bsakel/dsky-ha-terminal/software/README.md

# Pi Zero 2 W software (to do)

The Pi Zero 2 W runs the HyperPixel 4.0 Touch with the Pimoroni driver overlay. It shows a DSKY-style Home Assistant UI, for example a kiosk browser or a small native app, talks to the RP2040 over USB serial, and maps VERB/NOUN key sequences to Home Assistant services.
