bsakel/dsky-ha-terminal/docs/img/ha_front.png

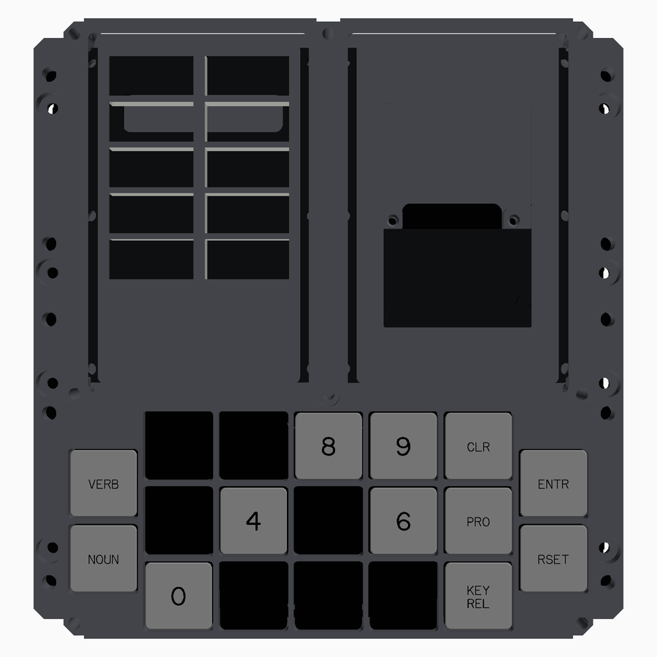
docs/img/ha_front.png
