bsakel/dsky-ha-terminal/docs/img/ha_rear.png

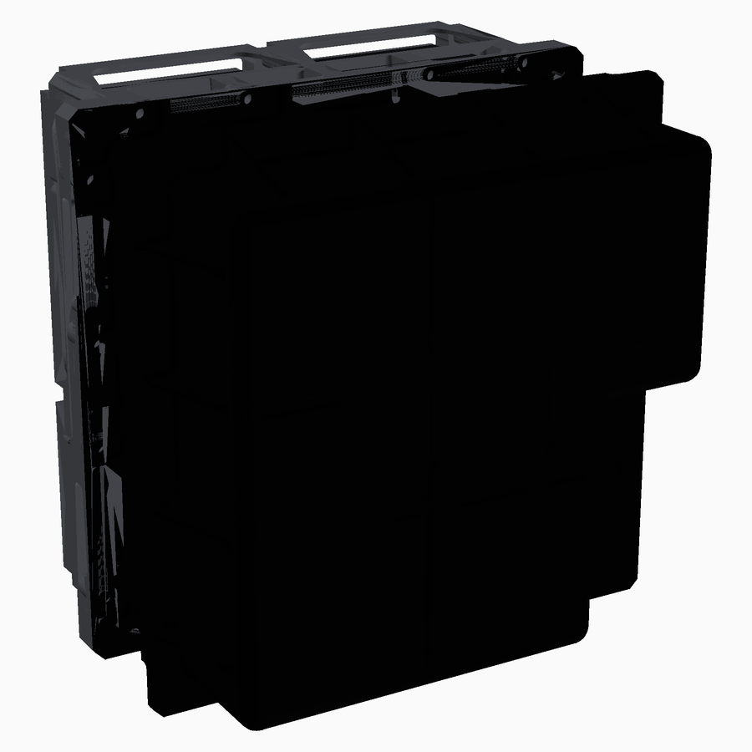
docs/img/ha_rear.png
