bsakel/dsky-ha-terminal/docs/img/keyboard_board.png

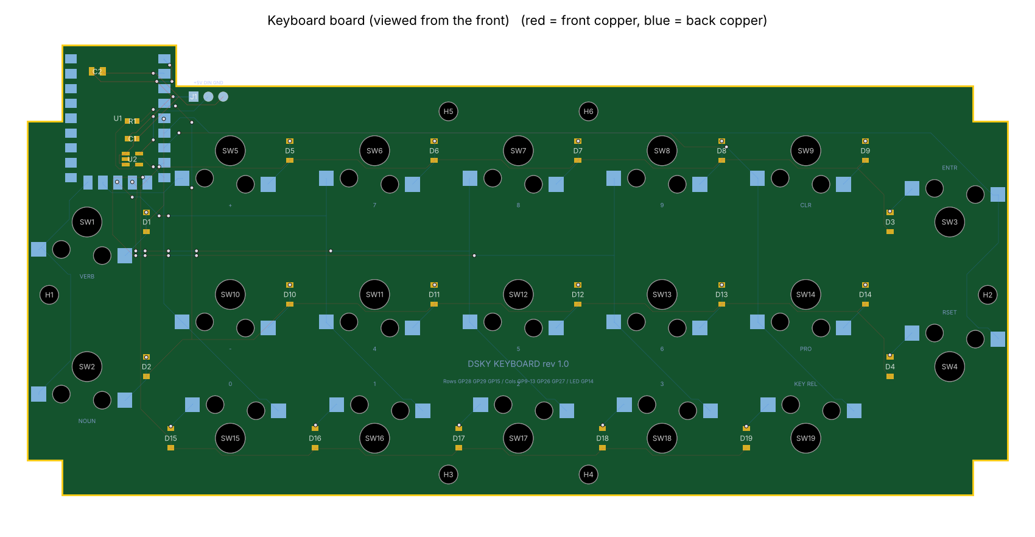
docs/img/keyboard_board.png
