bsakel/dsky-ha-terminal/docs/img/status_board.png

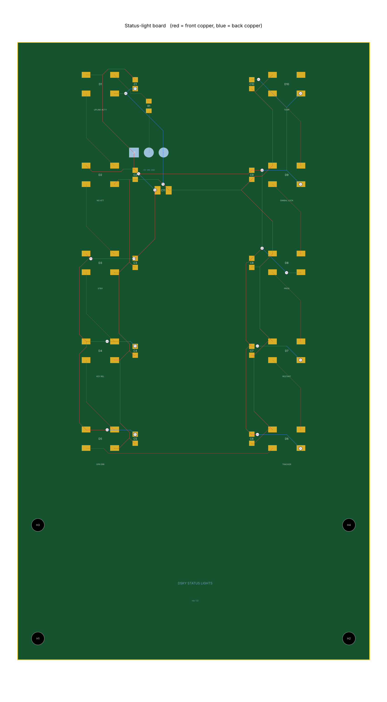
docs/img/status_board.png
