bsakel/dsky-ha-terminal/hardware/pcb/jlcpcb/keyboard-board/keyboard_board_BOM.csv

Comment | Designator | Footprint | JLCPCB Part #
100nF | C1 | C_0603 | C14663
10uF | C2 | C_0805 | C15850
1N4148W | D1,D2,D3,D4,D5,D6,D7,D8,D9,D10,D11,D12,D13,D14,D15,D16,D17,D18,D19 | D_SOD-123 | C81598
330R | R1 | R_0603 | C23138
74AHCT1G125 | U2 | SOT-23-5 | C7484
