bsakel/dsky-ha-terminal/hardware/pcb/jlcpcb/status-board/status_board_BOM.csv

Comment | Designator | Footprint | JLCPCB Part #
100nF | C1,C2,C3,C4,C5,C6,C7,C8,C9,C10 | C_0603 | C14663
10uF | C11 | C_0805 | C15850
330R | R1 | R_0603 | C23138
WS2812B | D1,D2,D3,D4,D5,D6,D7,D8,D9,D10 | WS2812B_5050 | C2761795
