bsakel/dsky-ha-terminal/hardware/cad/DSKY_HA_Terminal.step

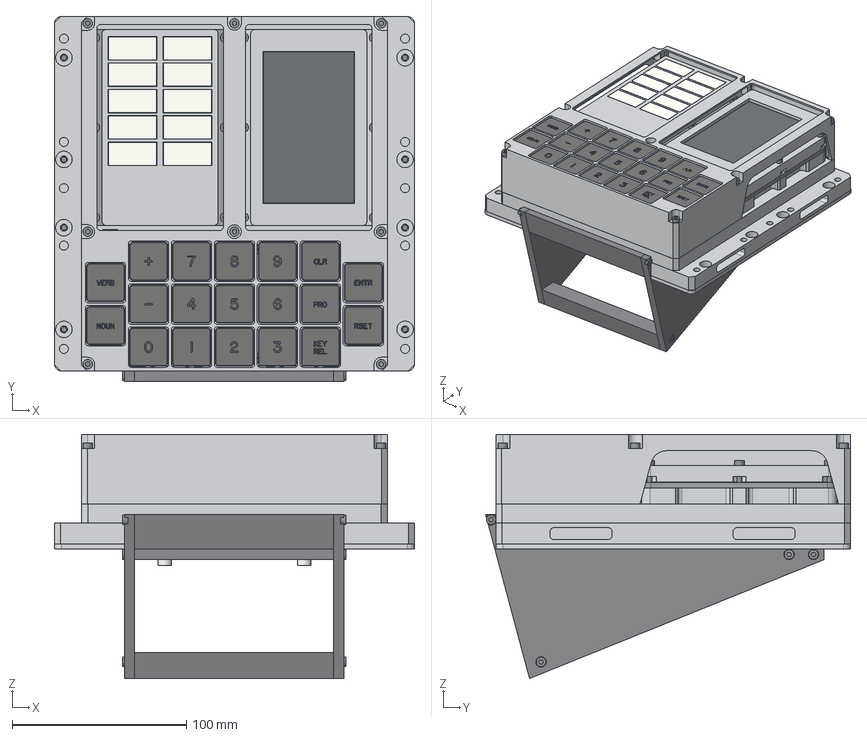
[picture p7: CAD file, 2026-11-09]
hardware/cad/DSKY_HA_Terminal.step
206.3 x 209.2 x 139.9 mm
2004739A Front chassis
M3x35 socket cap screw x 8
2004968E Mid frame - front half
2004968E Mid frame - back half
Dowel pin 3x8 x 5
Heat-set insert M3x5 (5.2 hole) x 39
Heat-set insert M3x4 (4.1 hole) x 8
2004919E Module plate
1006315A Seal plate
M3x12 button head screw x 19
1006387D Status light housing
1006387D Status light cover
LED splitter
Status light lens x 10
M3x16 socket cap screw x 18
1006315G Display housing (HyperPixel)
1006315G Display cover (HyperPixel)
HyperPixel 4.0 Touch
Raspberry Pi Zero 2 W
Standoff M2.5x8.5 M-F x 2
HyperPixel spacer (long)
Zero spacer (short)
M2.5x16 socket cap screw
M2.5x10 socket cap screw
M2.5x5 socket cap screw
Key VERB cap (1005022-001)
Key body x 19
Gateron LP 2.0 switch x 19
Key NOUN cap (1005022-002)
Key ENTR cap (1005022-003)
Key RSET cap (1005022-007)
Key PLUS cap (1005022-008)
Key 7 cap (1005022-017)
Key 8 cap (1005022-018)
Key 9 cap (1005022-019)
Key CLR cap (1005022-004)
Key MINUS cap (1005022-009)
Key 4 cap (1005022-014)
Key 5 cap (1005022-015)
Key 6 cap (1005022-016)
Key PRO cap (1005022-005)
Key 0 cap (1005022-010)
Key 1 cap (1005022-011)
Key 2 cap (1005022-012)
Key 3 cap (1005022-013)
Key KEY_REL cap (1005022-006)
Stand cheek (left)
Stand cheek (right)
Stand top bar
Stand ledge bar
Stand foot bar
M3x12 socket cap screw x 8
M4x12 screw + nut x 2
Back plate
M3x6 button head screw x 16
Status light PCB (custom)
Switch plate (low profile)
Keyboard PCB (custom)
RP2040-Zero x 2
Keyboard spacer x 6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
