bsakel/dsky-ha-terminal/hardware/pcb/status-board/status_board.kicad_pcb

## KiCad design hardware/pcb/status-board/status_board.kicad_pcb (2026-11-09)

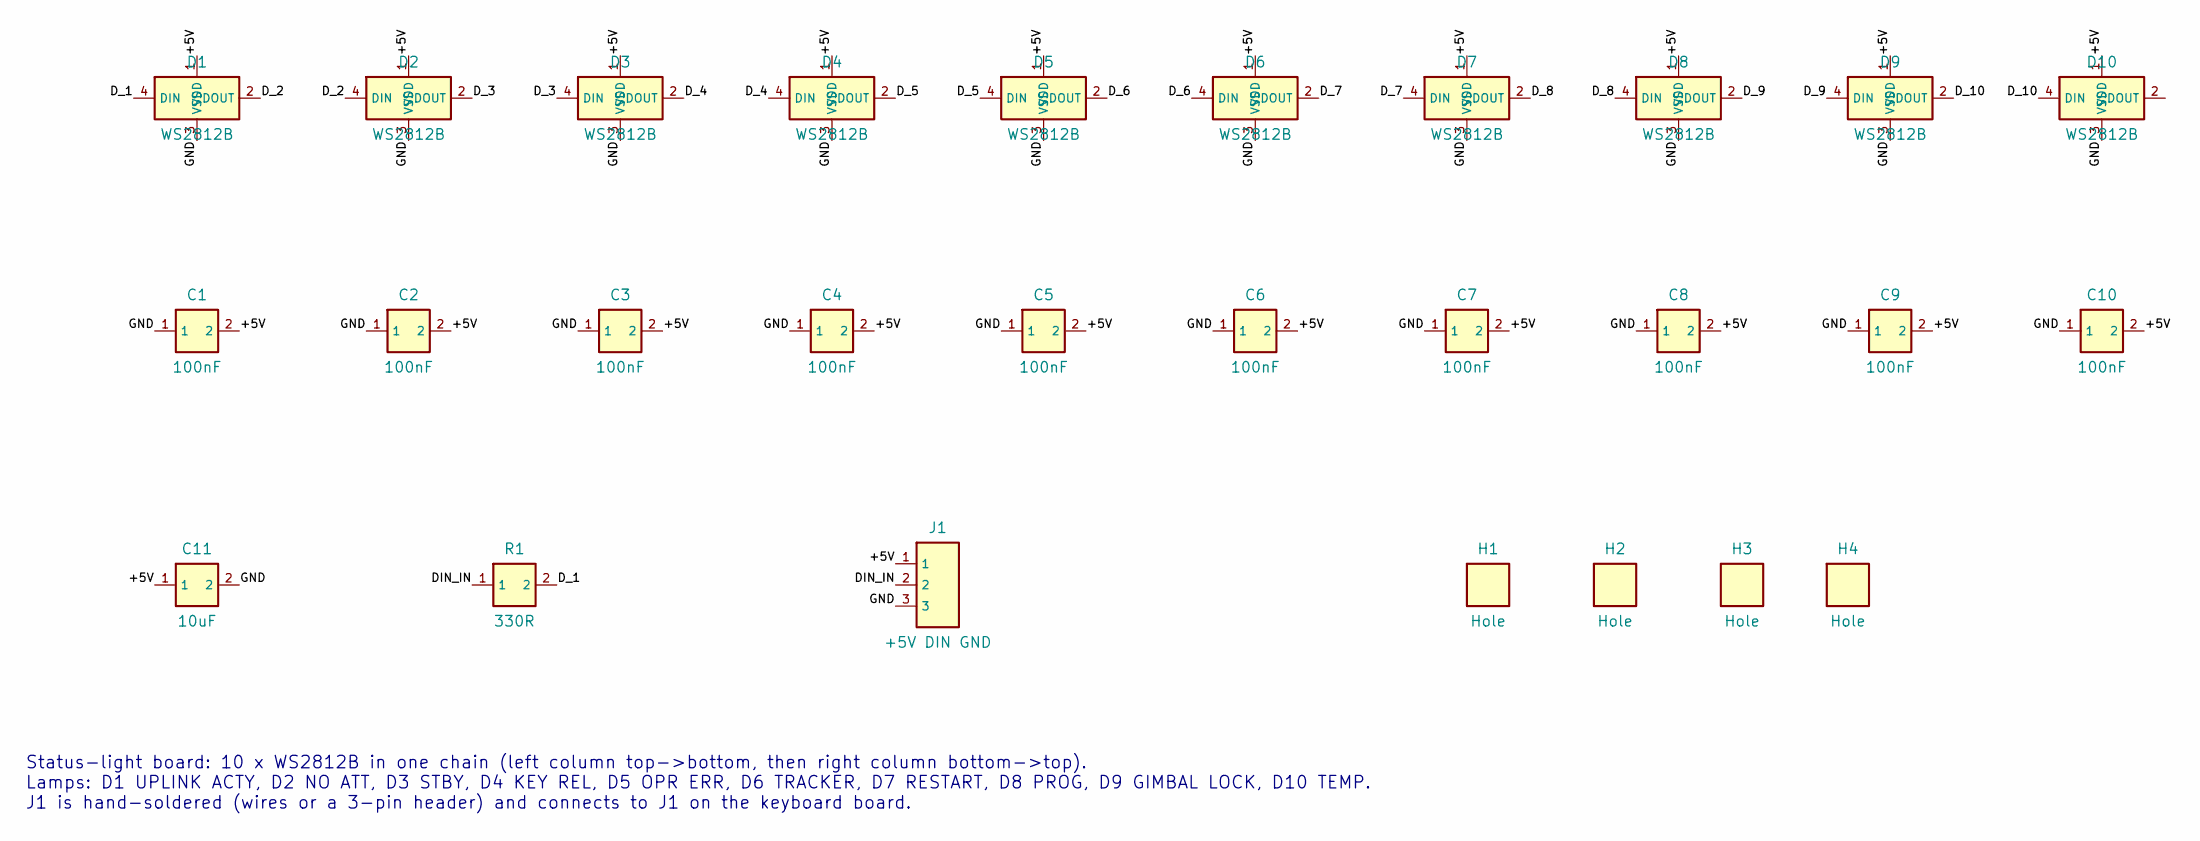
[picture p8: schematic status_board.kicad_sch, DSKY status-light board]

Parts:
C1, C2, C3, C4, C5, C6, C7, C8, C9, C10: 100nF; C_0603; MPN CC0603KRX7R9BB104; LCSC C14663
C11: 10uF; C_0805; MPN CL21A106KAYNNNE; LCSC C15850
D1, D2, D3, D4, D5, D6, D7, D8, D9, D10: WS2812B; WS2812B_5050; MPN WS2812B-B/T; LCSC C2761795
H1, H2, H3, H4: Hole; Hole_2.2
J1: +5V DIN GND; Conn_1x03_P2.54
R1: 330R; R_0603; MPN 0603WAF3300T5E; LCSC C23138

Connections:
+5V: C1.2, C2.2, C3.2, C4.2, C5.2, C6.2, C7.2, C8.2, C9.2, C10.2, C11.1, D1.1 (VDD), D2.1 (VDD), D3.1 (VDD), D4.1 (VDD), D5.1 (VDD), D6.1 (VDD), D7.1 (VDD), D8.1 (VDD), D9.1 (VDD), D10.1 (VDD), J1.1
DIN_IN: J1.2, R1.1
D_1: D1.4 (DIN), R1.2
D_2: D1.2 (DOUT), D2.4 (DIN)
D_3: D2.2 (DOUT), D3.4 (DIN)
D_4: D3.2 (DOUT), D4.4 (DIN)
D_5: D4.2 (DOUT), D5.4 (DIN)
D_6: D5.2 (DOUT), D6.4 (DIN)
D_7: D6.2 (DOUT), D7.4 (DIN)
D_8: D7.2 (DOUT), D8.4 (DIN)
D_9: D8.2 (DOUT), D9.4 (DIN)
D_10: D9.2 (DOUT), D10.4 (DIN)
GND: C1.1, C2.1, C3.1, C4.1, C5.1, C6.1, C7.1, C8.1, C9.1, C10.1, C11.2, D1.3 (VSS), D2.3 (VSS), D3.3 (VSS), D4.3 (VSS), D5.3 (VSS), D6.3 (VSS), D7.3 (VSS), D8.3 (VSS), D9.3 (VSS), D10.3 (VSS), J1.3

Notes on the sheet:
Status-light board: 10 x WS2812B in one chain (left column top->bottom, then right column bottom->top). Lamps: D1 UPLINK ACTY, D2 NO ATT, D3 STBY, D4 KEY REL, D5 OPR ERR, D6 TRACKER, D7 RESTART, D8 PROG, D9 GIMBAL LOCK, D10 TEMP. J1 is hand-soldered (wires or a 3-pin header) and connects to J1 on t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

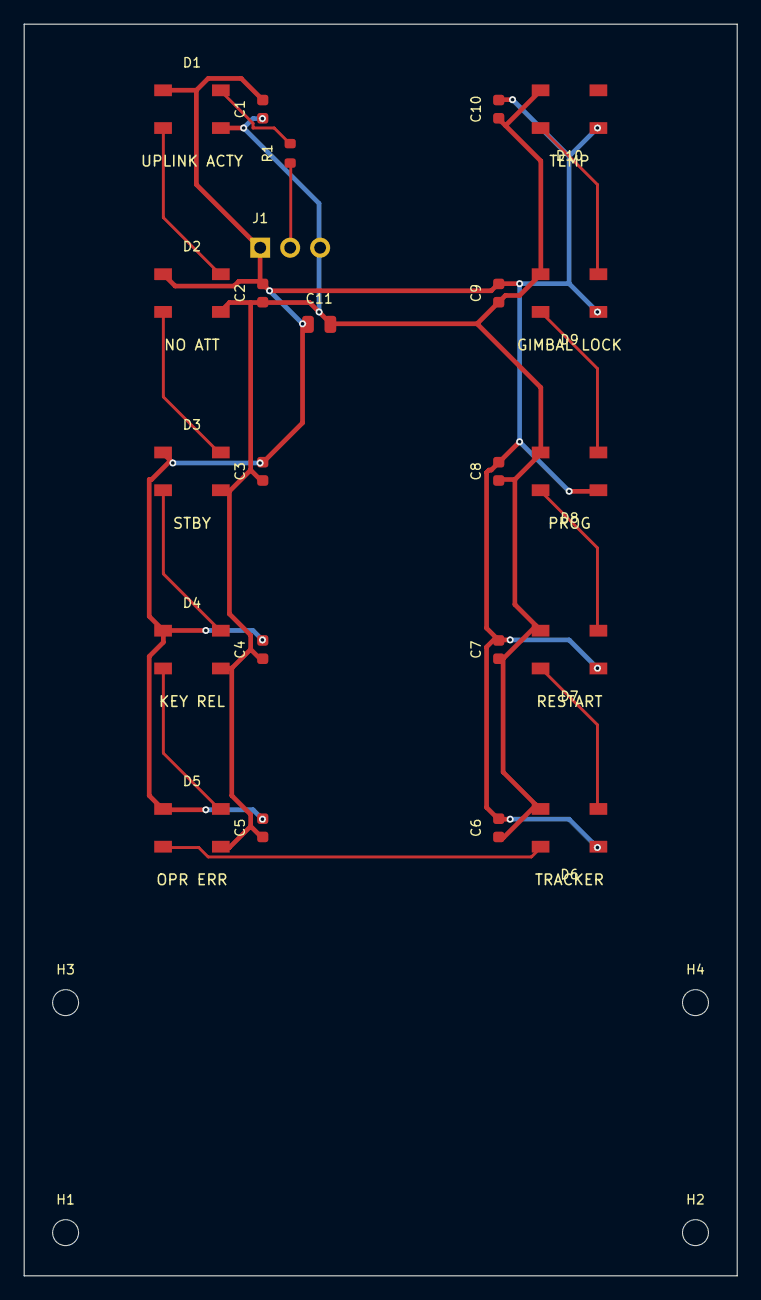
[picture p9: board status_board.kicad_pcb from above]

Board: 2 copper layers, 60.5 x 106.1 mm, 27 parts (0 on the bottom side), 13 nets.
