bsakel/dsky-ha-terminal/hardware/pcb/keyboard-board/keyboard_board.kicad_pcb

## KiCad design hardware/pcb/keyboard-board/keyboard_board.kicad_pcb (2026-11-09)

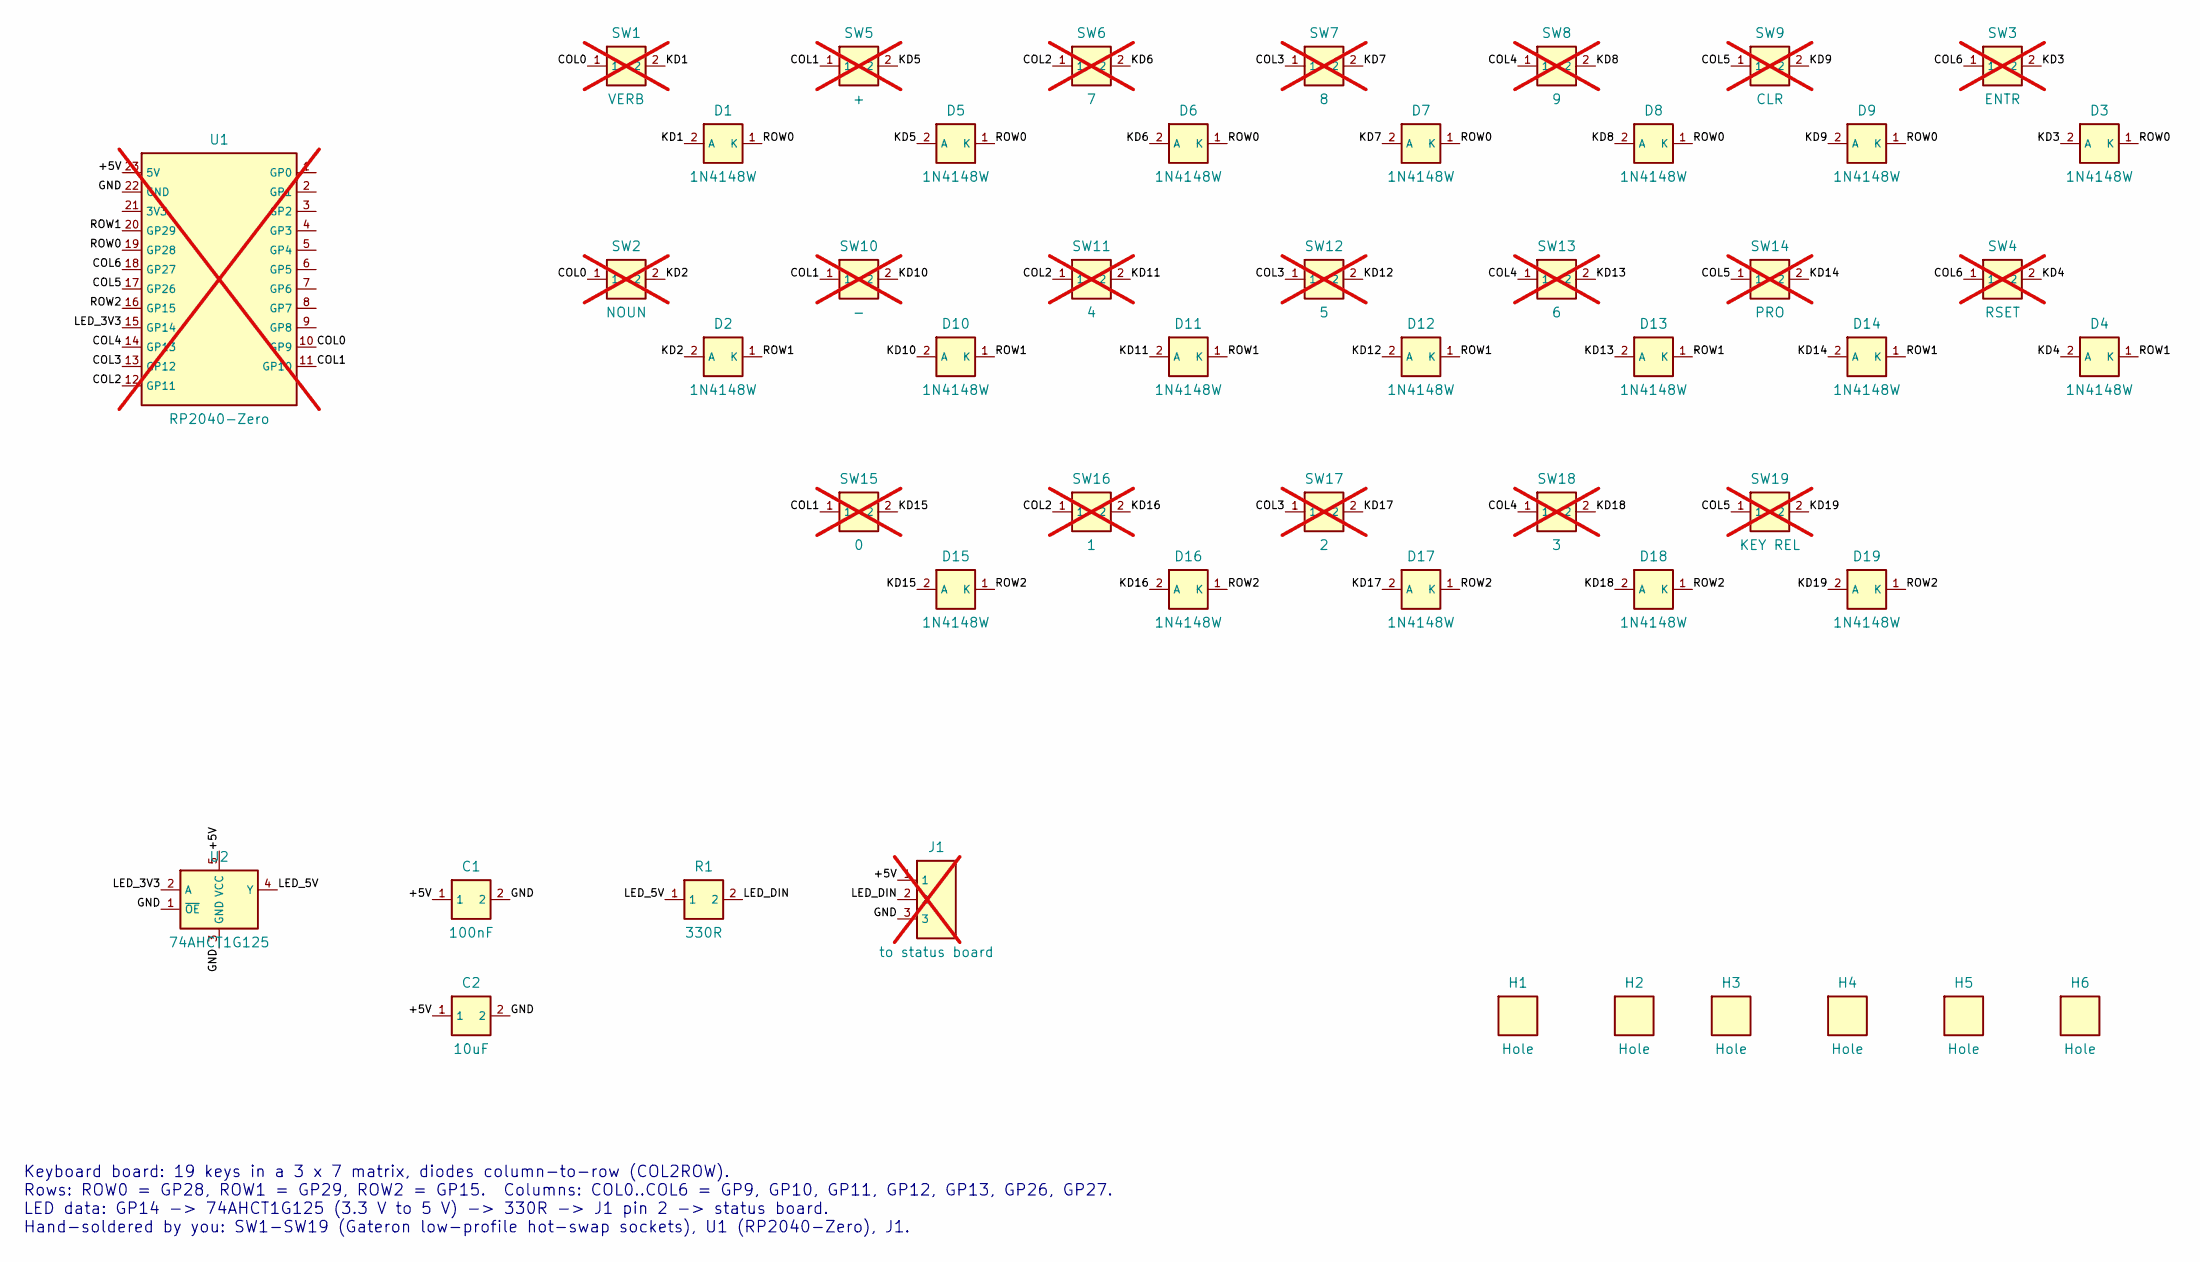
[picture p10: schematic keyboard_board.kicad_sch, DSKY keyboard board]

Parts:
C1: 100nF; C_0603; MPN CC0603KRX7R9BB104; LCSC C14663
C2: 10uF; C_0805; MPN CL21A106KAYNNNE; LCSC C15850
D1, D2, D3, D4, D5, D6, D7, D8, D9, D10, D11, D12, D13, D14, D15, D16, D17, D18, D19: 1N4148W; D_SOD-123; MPN 1N4148W; LCSC C81598
H1, H2, H3, H4, H5, H6: Hole; MountingHole_M3
J1: to status board; Conn_1x03_P2.54; not fitted
R1: 330R; R_0603; MPN 0603WAF3300T5E; LCSC C23138
SW1: VERB; Gateron_LP_Hotswap; not fitted
SW2: NOUN; Gateron_LP_Hotswap; not fitted
SW3: ENTR; Gateron_LP_Hotswap; not fitted
SW4: RSET; Gateron_LP_Hotswap; not fitted
SW5: +; Gateron_LP_Hotswap; not fitted
SW6: 7; Gateron_LP_Hotswap; not fitted
SW7: 8; Gateron_LP_Hotswap; not fitted
SW8: 9; Gateron_LP_Hotswap; not fitted
SW9: CLR; Gateron_LP_Hotswap; not fitted
SW10: -; Gateron_LP_Hotswap; not fitted
SW11: 4; Gateron_LP_Hotswap; not fitted
SW12: 5; Gateron_LP_Hotswap; not fitted
SW13: 6; Gateron_LP_Hotswap; not fitted
SW14: PRO; Gateron_LP_Hotswap; not fitted
SW15: 0; Gateron_LP_Hotswap; not fitted
SW16: 1; Gateron_LP_Hotswap; not fitted
SW17: 2; Gateron_LP_Hotswap; not fitted
SW18: 3; Gateron_LP_Hotswap; not fitted
SW19: KEY REL; Gateron_LP_Hotswap; not fitted
U1: RP2040-Zero; not fitted
U2: 74AHCT1G125; SOT-23-5; MPN SN74AHCT1G125DBVR; LCSC C7484

Connections:
+5V: C1.1, C2.1, J1.1, U1.23 (5V), U2.5 (VCC)
COL0: SW1.1, SW2.1, U1.10 (GP9)
COL1: SW5.1, SW10.1, SW15.1, U1.11 (GP10)
COL2: SW6.1, SW11.1, SW16.1, U1.12 (GP11)
COL3: SW7.1, SW12.1, SW17.1, U1.13 (GP12)
COL4: SW8.1, SW13.1, SW18.1, U1.14 (GP13)
COL5: SW9.1, SW14.1, SW19.1, U1.17 (GP26)
COL6: SW3.1, SW4.1, U1.18 (GP27)
GND: C1.2, C2.2, J1.3, U1.22 (GND), U2.1 (~OE), U2.3 (GND)
KD1: D1.2 (A), SW1.2
KD2: D2.2 (A), SW2.2
KD3: D3.2 (A), SW3.2
KD4: D4.2 (A), SW4.2
KD5: D5.2 (A), SW5.2
KD6: D6.2 (A), SW6.2
KD7: D7.2 (A), SW7.2
KD8: D8.2 (A), SW8.2
KD9: D9.2 (A), SW9.2
KD10: D10.2 (A), SW10.2
KD11: D11.2 (A), SW11.2
KD12: D12.2 (A), SW12.2
KD13: D13.2 (A), SW13.2
KD14: D14.2 (A), SW14.2
KD15: D15.2 (A), SW15.2
KD16: D16.2 (A), SW16.2
KD17: D17.2 (A), SW17.2
KD18: D18.2 (A), SW18.2
KD19: D19.2 (A), SW19.2
LED_3V3: U1.15 (GP14), U2.2 (A)
LED_5V: R1.1, U2.4 (Y)
LED_DIN: J1.2, R1.2
ROW0: D1.1 (K), D3.1 (K), D5.1 (K), D6.1 (K), D7.1 (K), D8.1 (K), D9.1 (K), U1.19 (GP28)
ROW1: D2.1 (K), D4.1 (K), D10.1 (K), D11.1 (K), D12.1 (K), D13.1 (K), D14.1 (K), U1.20 (GP29)
ROW2: D15.1 (K), D16.1 (K), D17.1 (K), D18.1 (K), D19.1 (K), U1.16 (GP15)

Notes on the sheet:
Keyboard board: 19 keys in a 3 x 7 matrix, diodes column-to-row (COL2ROW). Rows: ROW0 = GP28, ROW1 = GP29, ROW2 = GP15. Columns: COL0..COL6 = GP9, GP10, GP11, GP12, GP13, GP26, GP27. LED data: GP14 -> 74AHCT1G125 (3.3 V to 5 V) -> 330R -> J1 pin 2 -> status board. Hand-soldered by you: SW1-SW19 (Ga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

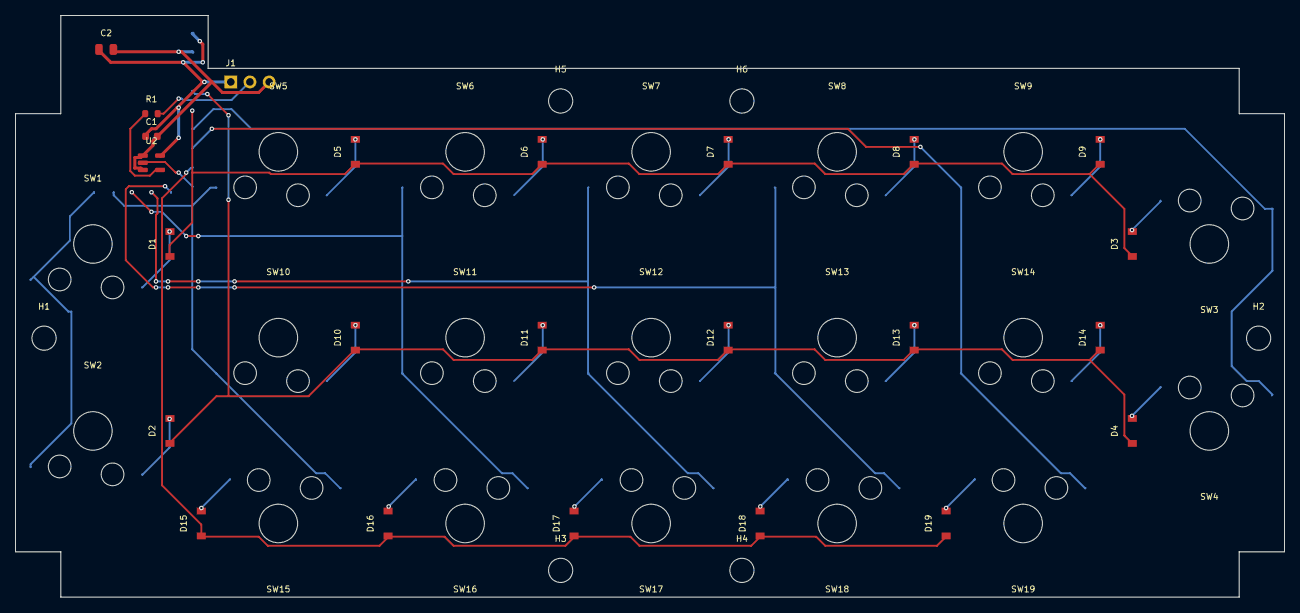
[picture p11: board keyboard_board.kicad_pcb from above]

Board: 2 copper layers, 168.0 x 77.0 mm, 50 parts (1 on the bottom side), 34 nets.
