bsakel/dsky-ha-terminal/hardware/diy/diy_wiring.kicad_sch

## KiCad design hardware/diy/diy_wiring.kicad_sch (2026-11-09)

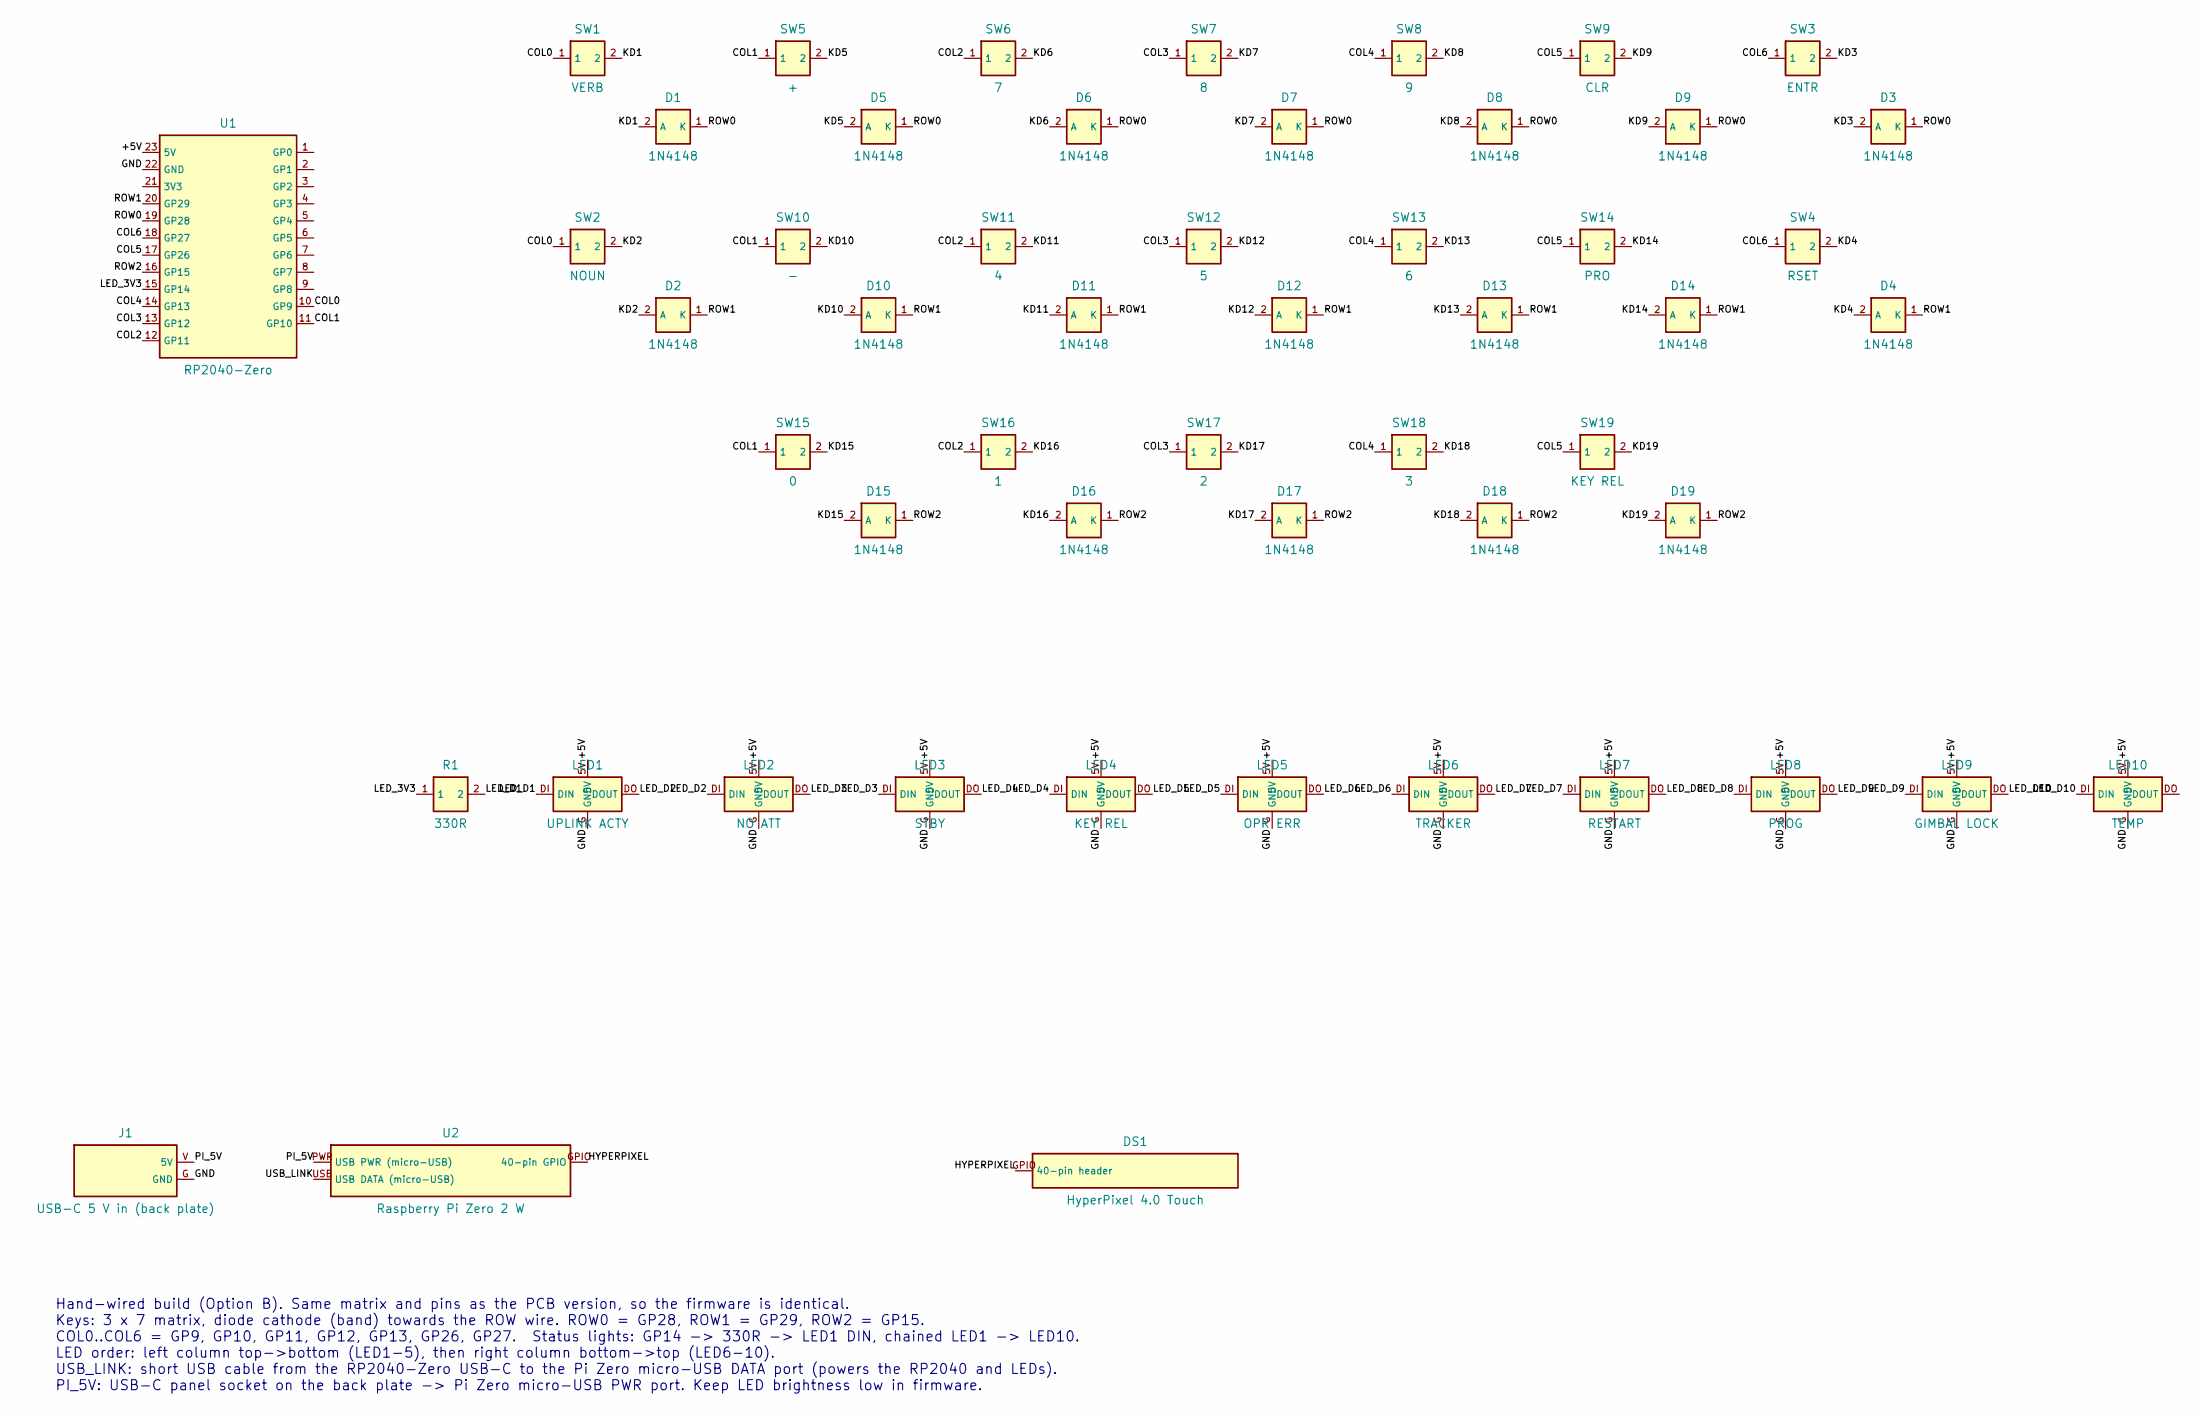
[picture p12: schematic diy_wiring.kicad_sch]

Parts:
D1, D2, D3, D4, D5, D6, D7, D8, D9, D10, D11, D12, D13, D14, D15, D16, D17, D18, D19: 1N4148
DS1: HyperPixel 4.0 Touch
J1: USB-C 5 V in (back plate)
LED1: UPLINK ACTY
LED2: NO ATT
LED3: STBY
LED4: KEY REL
LED5: OPR ERR
LED6: TRACKER
LED7: RESTART
LED8: PROG
LED9: GIMBAL LOCK
LED10: TEMP
R1: 330R
SW1: VERB
SW2: NOUN
SW3: ENTR
SW4: RSET
SW5: +
SW6: 7
SW7: 8
SW8: 9
SW9: CLR
SW10: -
SW11: 4
SW12: 5
SW13: 6
SW14: PRO
SW15: 0
SW16: 1
SW17: 2
SW18: 3
SW19: KEY REL
U1: RP2040-Zero
U2: Raspberry Pi Zero 2 W

Connections:
+5V: LED1.5V, LED2.5V, LED3.5V, LED4.5V, LED5.5V, LED6.5V, LED7.5V, LED8.5V, LED9.5V, LED10.5V, U1.23 (5V)
COL0: SW1.1, SW2.1, U1.10 (GP9)
COL1: SW5.1, SW10.1, SW15.1, U1.11 (GP10)
COL2: SW6.1, SW11.1, SW16.1, U1.12 (GP11)
COL3: SW7.1, SW12.1, SW17.1, U1.13 (GP12)
COL4: SW8.1, SW13.1, SW18.1, U1.14 (GP13)
COL5: SW9.1, SW14.1, SW19.1, U1.17 (GP26)
COL6: SW3.1, SW4.1, U1.18 (GP27)
GND: J1.G (GND), LED1.G (GND), LED2.G (GND), LED3.G (GND), LED4.G (GND), LED5.G (GND), LED6.G (GND), LED7.G (GND), LED8.G (GND), LED9.G (GND), LED10.G (GND), U1.22 (GND)
HYPERPIXEL: DS1.GPIO, U2.GPIO (40-pin GPIO)
KD1: D1.2 (A), SW1.2
KD2: D2.2 (A), SW2.2
KD3: D3.2 (A), SW3.2
KD4: D4.2 (A), SW4.2
KD5: D5.2 (A), SW5.2
KD6: D6.2 (A), SW6.2
KD7: D7.2 (A), SW7.2
KD8: D8.2 (A), SW8.2
KD9: D9.2 (A), SW9.2
KD10: D10.2 (A), SW10.2
KD11: D11.2 (A), SW11.2
KD12: D12.2 (A), SW12.2
KD13: D13.2 (A), SW13.2
KD14: D14.2 (A), SW14.2
KD15: D15.2 (A), SW15.2
KD16: D16.2 (A), SW16.2
KD17: D17.2 (A), SW17.2
KD18: D18.2 (A), SW18.2
KD19: D19.2 (A), SW19.2
LED_3V3: R1.1, U1.15 (GP14)
LED_D1: LED1.DI (DIN), R1.2
LED_D2: LED1.DO (DOUT), LED2.DI (DIN)
LED_D3: LED2.DO (DOUT), LED3.DI (DIN)
LED_D4: LED3.DO (DOUT), LED4.DI (DIN)
LED_D5: LED4.DO (DOUT), LED5.DI (DIN)
LED_D6: LED5.DO (DOUT), LED6.DI (DIN)
LED_D7: LED6.DO (DOUT), LED7.DI (DIN)
LED_D8: LED7.DO (DOUT), LED8.DI (DIN)
LED_D9: LED8.DO (DOUT), LED9.DI (DIN)
LED_D10: LED9.DO (DOUT), LED10.DI (DIN)
PI_5V: J1.V (5V), U2.PWR (USB PWR (micro-USB))
ROW0: D1.1 (K), D3.1 (K), D5.1 (K), D6.1 (K), D7.1 (K), D8.1 (K), D9.1 (K), U1.19 (GP28)
ROW1: D2.1 (K), D4.1 (K), D10.1 (K), D11.1 (K), D12.1 (K), D13.1 (K), D14.1 (K), U1.20 (GP29)
ROW2: D15.1 (K), D16.1 (K), D17.1 (K), D18.1 (K), D19.1 (K), U1.16 (GP15)
USB_LINK: U2.USB (USB DATA (micro-USB))

Notes on the sheet:
Hand-wired build (Option B). Same matrix and pins as the PCB version, so the firmware is identical. Keys: 3 x 7 matrix, diode cathode (band) towards the ROW wire. ROW0 = GP28, ROW1 = GP29, ROW2 = GP15. COL0..COL6 = GP9, GP10, GP11, GP12, GP13, GP26, GP27. Status lights: GP14 -> 330R -> LED1 DIN, ch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
